eSpark-Backup/richardtilt-breakoutpcb/Design Files/Breakout_PCB_Board_Design-v1.1/Renderings/2D_TopView.PNG

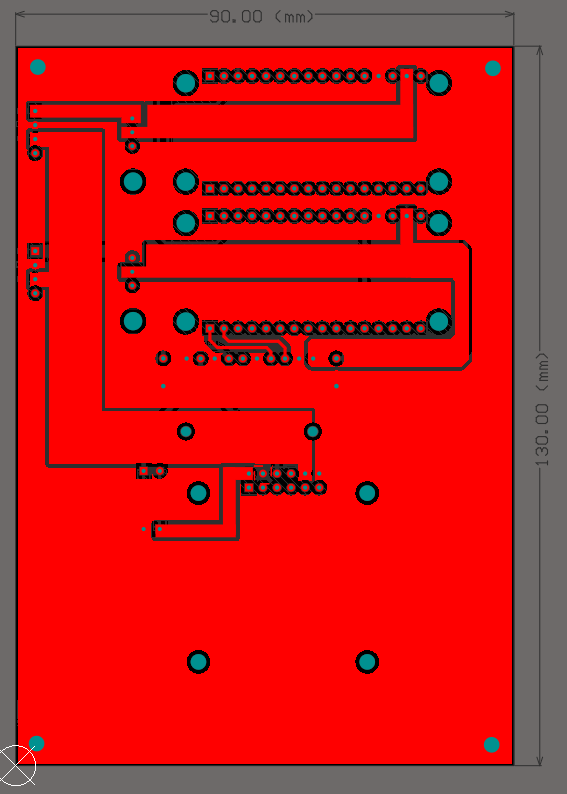
Design Files/Breakout_PCB_Board_Design-v1.1/Renderings/2D_TopView.PNG
