eSpark-Backup/richardtilt-breakoutpcb/Design Files/Breakout_PCB_Board_Design-v1.1/Renderings/Isometric_View.PNG

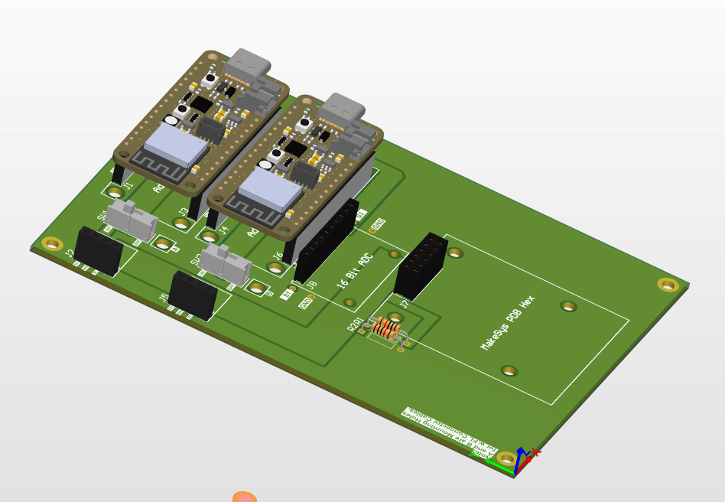
Design Files/Breakout_PCB_Board_Design-v1.1/Renderings/Isometric_View.PNG
