eSpark-Backup/richardtilt-breakoutpcb/Design Files/Breakout_PCB_Board_Design-v1.1/BOM/Client_BOM.xlsx

 |  | Component list |  | Bill of Materials for Project [Breakout_PCB_Board_Design
 |  | Source Data From: |  | Breakout_PCB_Board_Design
 |  | Project: |  | Breakout_PCB_Board_Design
 |  | Variant: |  | None
# | Item Type | Designator | Description | Footprint | Manufacturer Part Number | Manufacturer | Value | Quantity | Remarks
1 | Header | J1, J3, J4, J6 | 2.54mm Plugin 16P Brass Straight 1x16P Plugin,P=2.54mm Female Headers ROHS | HDR1X16 Female | 2685Y-116CNG1SNA01 | HOAUC | 2685Y-116CNG1SNA01 | 4
2 | Header | J2, J5 | 2.54mm Plugin 3A bronze -40℃~+105℃ Straight 1x4P Top 4 Square Holes Plugin,P=2.54mm Female Headers ROHS | HDR1X4 Female | C2718488 | BOOMELE | C2718488 | 2
3 | Header | J7 | 2.54mm 2.54mm 双排 12P Brass Straight 2x6P Plugin,P=2.54mm Female Headers ROHS | HDR2X6 Female | PM254V-12-12-H85 | XFCN | PM254V-12-12-H85 | 1
4 | Header | J8 | 2.54mm Plugin Gold 3A 10P Brass -40℃~+105℃ 250V 260℃ Straight 1x10P 8.5mm Top Square Holes Plugin,P=2.54mm Female Headers ROHS | HDR1X10 Female | X6511FV-10-C85D32 | XKB Connectivity | X6511FV-10-C85D32 | 1
5 | Resistor | R1, R2 | 1/4 watt Resistor | Custom | - | - | - | 2 | DNP
6 | Switch | SW1, SW2 | Switch Slide N.O./N.C. SPDT Top Slide 0.2A 30VDC PC Pins Thru-Hole | EG1218 | EG1218 | E-Switch | EG1218 | 2
 | Peripheral | - | Adafruit ESP32 Feather V2 w.FL Antenna - 8MB Flash + 2 MB PSRAM - STEMMA QT | - | - | Adafruit | - | 2
 | Peripheral | - | WiFi Antenna with w.FL | - | - | Airgain | - | 2
 | Peripheral | - | SparkFun BabyBuck Regulator Breakout - 3.3V (AP63203) | - | - | Sparkfun | - | 2
 | Peripheral | - | ADS1115 16 Bit | - | - | - | - | 1
 | Peripheral | - | PDB-HEX | - | - | Mateksys | - | 1
