eSpark-Backup/richardtilt-breakoutpcb/Design Files/Breakout_PCB_Board_Design-v1.1/Supporting Files/Breakout_PCB-v1.0.step

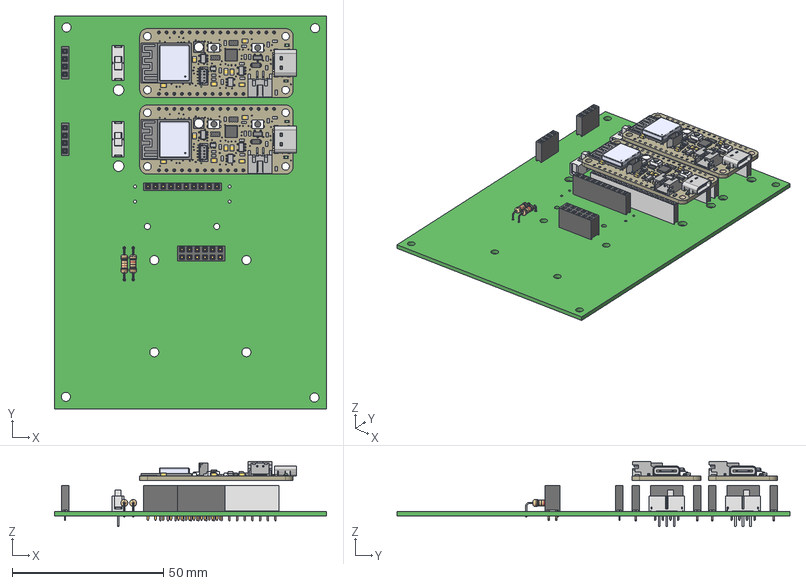
[picture p7: CAD file, 2024-04-16]
Design Files/Breakout_PCB_Board_Design-v1.1/Supporting Files/Breakout_PCB-v1.0.step
90.0 x 130.0 x 21.6 mm
User_Library-zl262-4s_p2-54_l10-66_w2-54_h8-5 x 2
Header_Female_1x16 x 4
EG1218--3DModel-STEP-520916 x 2
zl262-10s_p2-54_l25-9_w2-5_h8-5
Komponente29
Board x 2
0805-NO x 14
SOT23-5 x 4
SOD-123 x 2
JSTPH2_BATT x 2
SOT23-5_(1) x 2
CHIPLED_0603_NOOUTLINE x 4
0603-NO x 30
BTN_KMR2_4.6X2.8 x 4
SOT23-R x 2
RESPACK_4X0603 x 4
ESP32-PICO-MINI x 2
LED3535 x 2
JST_SH4_RA x 2
B1,27 x 4
USB_C_CUSB31-CFM2AX-01-X x 2
QFN24_4MM_SMSC x 2
SOT363 x 2
