eSpark-Backup/richardtilt-breakoutpcb/(list of files, cad)

Other CAD files:
Design Files/Breakout_PCB_Board_Design-v1.1/Supporting Files/Breakout_PCB-v1.0.DWG
Design Files/Breakout_PCB_Board_Design-v1.1/Supporting Files/Breakout_PCB-v1.0.DXF
