eSpark-Backup/richardtilt-breakoutpcb/Design Files/Breakout_PCB_Board_Design-v1.1/Schematics/Breakout_Board_Design-v1.0.pdf

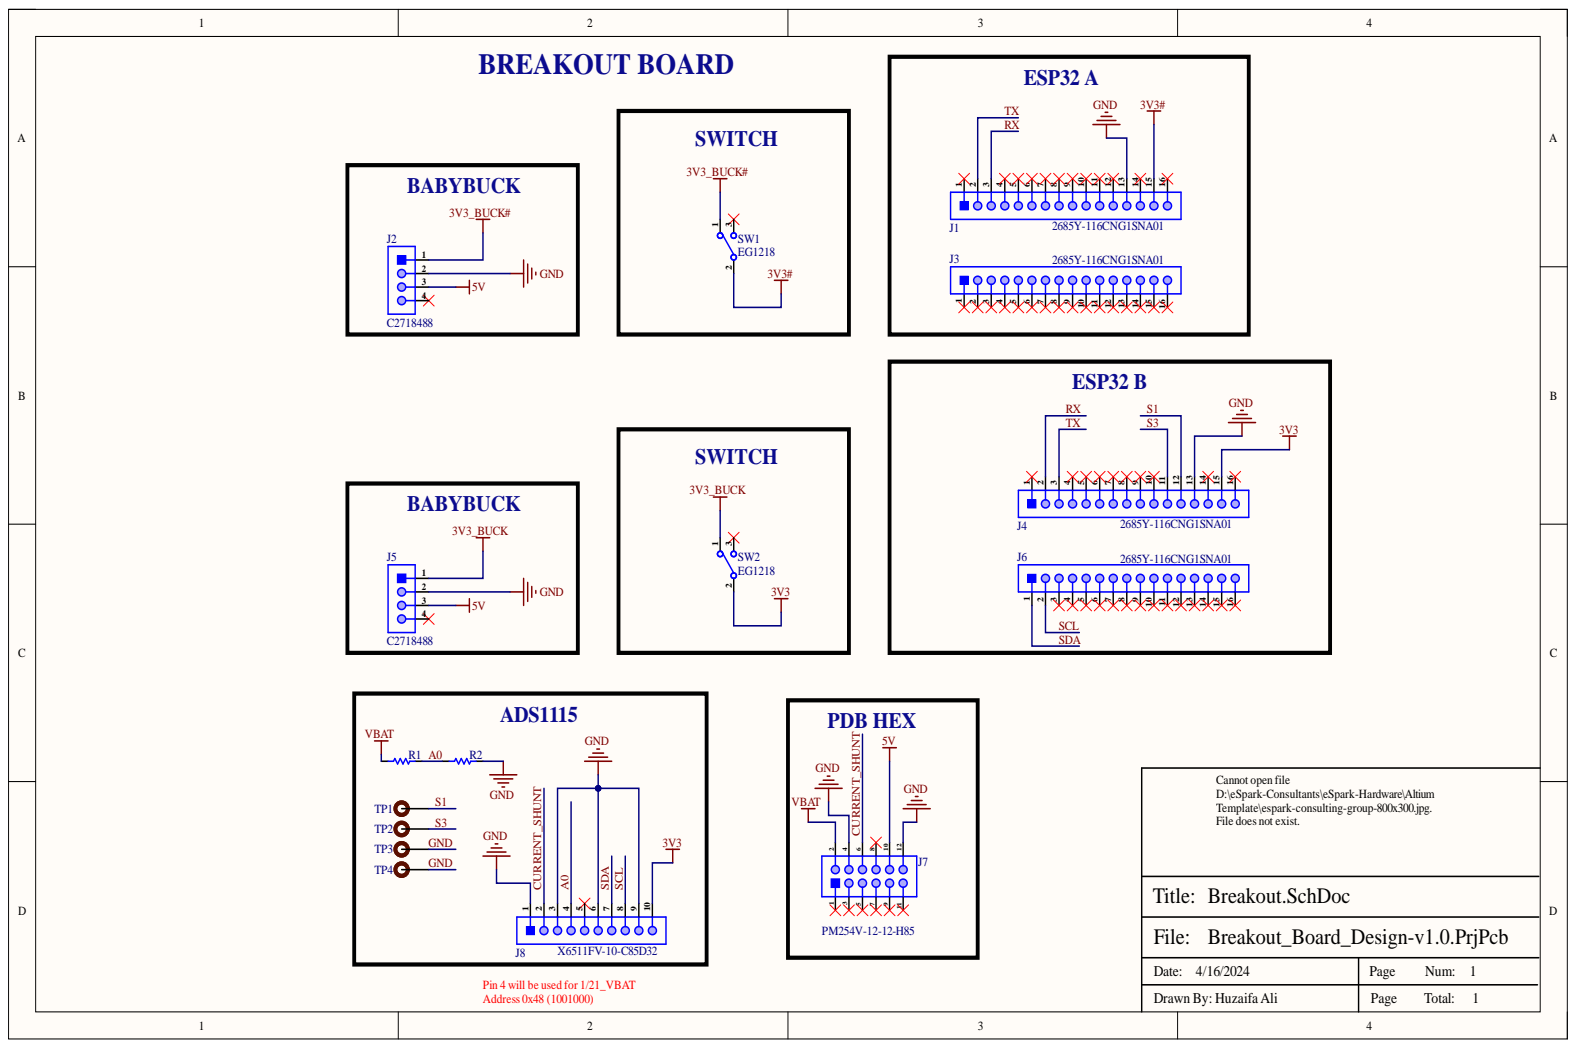
[picture p8: page 1]

Cannot open file
D:\eSpark-Consultants\eSpark-Hardware\Altium
Template\espark-consulting-group-800x300.jpg.
File does not exist.

Date: 4/16/2024 | Page Num: 1

Pin 4 will be used for 1/21_VBAT
Address 0x48 (1001000)

Drawn By: Huzaifa Ali | Page Total: 1
