eSpark-Backup/richardtilt-breakoutpcb/Design Files/Breakout_PCB_Board_Design-v1.1/Schematics/Assembly_Drawings-v1.0.pdf

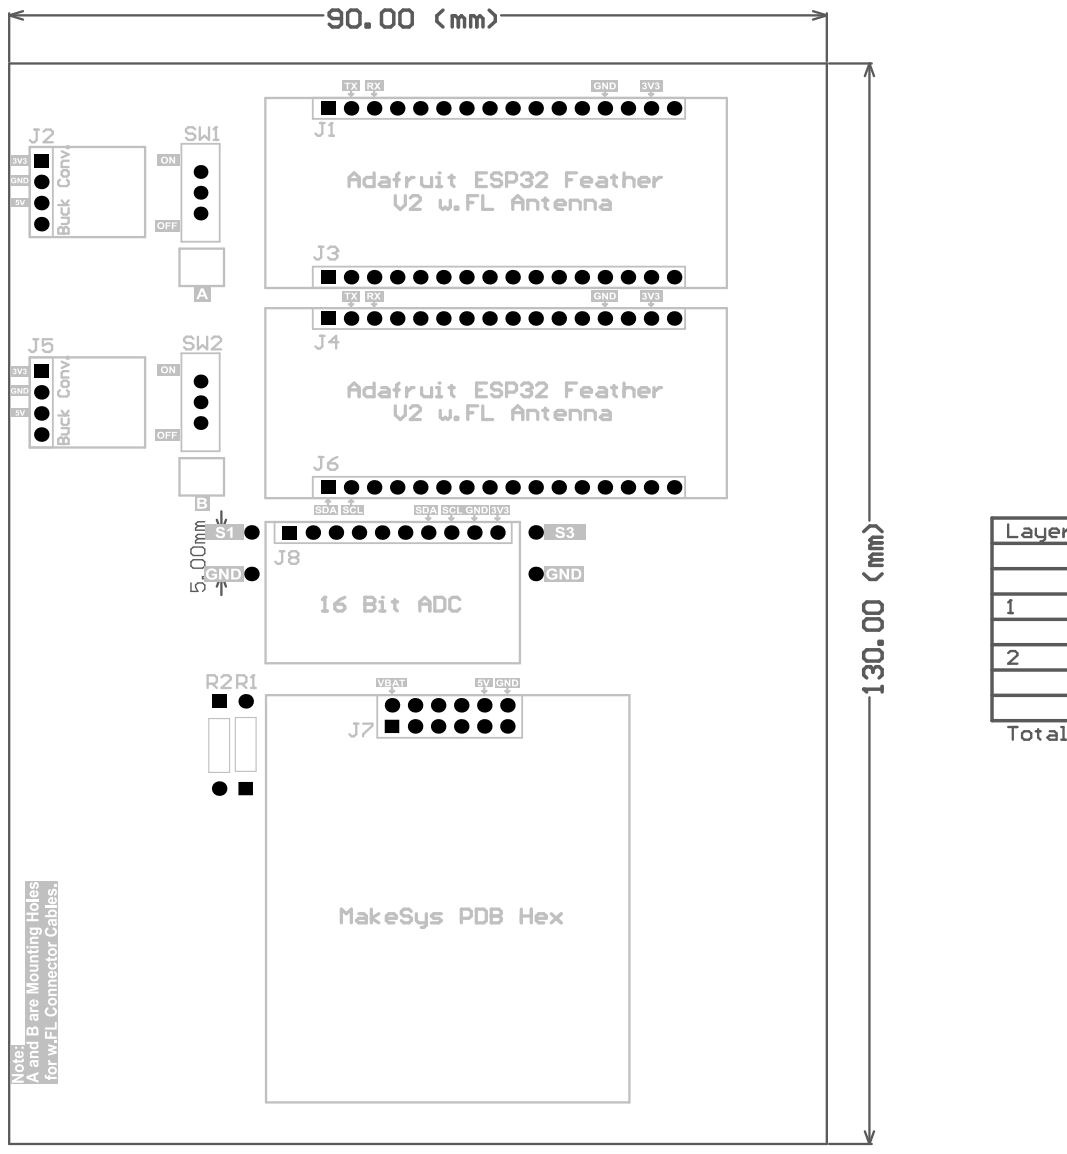
[picture p9: page 1]

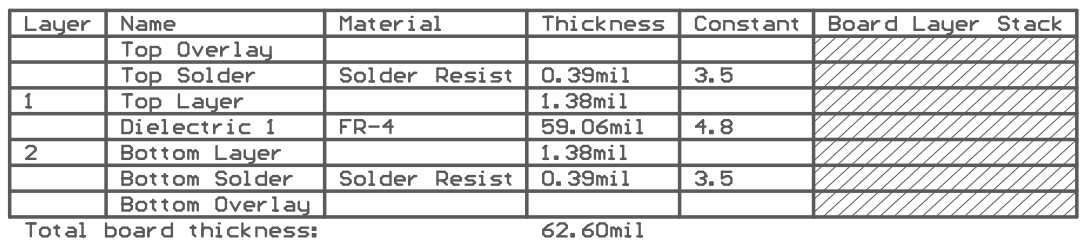
[picture p10: page 2]

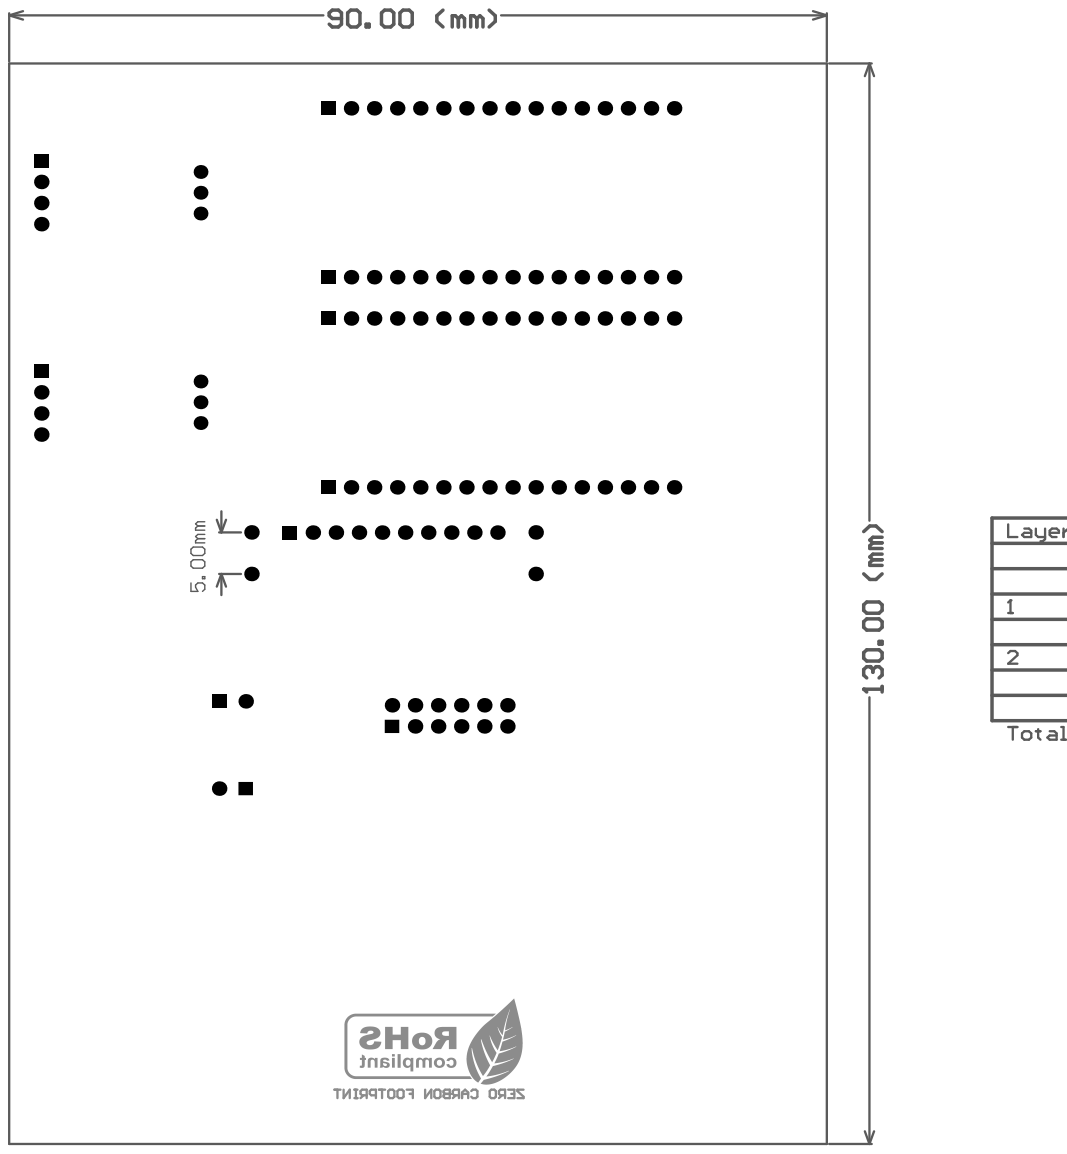
[picture p11: page 3]
