eSpark-Backup/richardtilt-breakoutpcb/(list of files, drawings)

Other design files:
Design Files/Breakout_PCB_Board_Design-v1.1/Breakout.SchDoc
Design Files/Breakout_PCB_Board_Design-v1.1/Breakout_Board_Design-v1.0.PrjPcb
Design Files/Breakout_PCB_Board_Design-v1.1/Breakout_PCB-v1.0.PcbDoc
Design Files/Breakout_PCB_Board_Design-v1.1/PcbLib1.PcbLib
Design Files/Breakout_PCB_Board_Design-v1.1/Schlib1.SchLib
