eSpark-Backup/richardtilt-breakoutpcb/(commit log)

2023-12-18 #1 Schematic in progress
    [Breakout_PCB_Board_Design.PrjPcb, Schlib1.SchLib, Sheet1.SchDoc]
2023-12-20 #1 Schematic completed
    [Breakout_PCB_Board_Design.PrjPcb, Header.SchDoc, Headers.SchDoc, PcbLib1.PcbLib, Schlib1.SchLib]
2023-12-20 #1 PDF added
    [Breakout_PCB_Board_Design.PrjPcb, Headers.SchDoc, PCB1.PcbDoc, PcbLib1.PcbLib]
2023-12-20 #1 Client BOM added
    [Client_BOM.xlsx]
2023-12-20 #2 Done: Deliverables generated.
    [Breakout_Board_Design-v1.0.PrjPcb, Breakout_PCB-v1.0.DWG, Breakout_PCB-v1.0.DXF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]
2023-12-21 #1 Schematic and PCB edited
    [Breakout.SchDoc, Breakout_PCB-v1.0.PcbDoc, Headers.SchDoc]
2023-12-21 #1 Comments added
    [Breakout.SchDoc]
2023-12-21 #1 Modifications done
    [Breakout.SchDoc, Breakout_Board_Design-v1.0.PrjPcb, Breakout_PCB-v1.0.PcbDoc]
2023-12-21 #2 Deliverables added
    [Breakout_Board_Design-v1.0.PrjPcb, Breakout_PCB-v1.0.DWG, Breakout_PCB-v1.0.DXF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]
2023-12-26 #2 PCB updated acc to change in netlabel and Fresh deliverables Generated
    [Breakout.SchDoc, Breakout_Board_Design-v1.0.PrjPcb, Breakout_PCB-v1.0.DWG, Breakout_PCB-v1.0.DXF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]
2023-12-26 #2 Fresh Deliverables generated after modifications in PCB.
    [Breakout.SchDoc, Breakout_Board_Design-v1.0.PrjPcb, Breakout_PCB-v1.0.DWG, Breakout_PCB-v1.0.DXF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]
2024-01-08 #3 Test Point Added
    [Breakout.SchDoc, Breakout_Board_Design-v1.0.PrjPcb, Breakout_PCB-v1.0.PcbDoc]
2024-01-09 #3 Branch name changed.
    [Breakout.SchDoc]
2024-04-16 Changes updated acc to #3
    [Breakout.SchDoc, Breakout_PCB-v1.0.PcbDoc]
2024-04-16 #3 Changes in Design Done: Deliverables Generated.
    [Breakout.SchDoc, Breakout_Board_Design-v1.0.PrjPcb, Breakout_PCB-v1.0.DWG, Breakout_PCB-v1.0.DXF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]
2024-04-17 #3 BOM updated with two resistors
    [Client_BOM.xlsx]
2024-04-17 File version added
    [Breakout.SchDoc, Breakout_Board_Design-v1.0.PrjPcb, Breakout_PCB-v1.0.DWG, Breakout_PCB-v1.0.DXF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]
